kkbubu/STM32CodeDemo/PROGRESS.md

# 任务进度

目标：STM32F103C8T6 HAL，7 路电磁阀控制垂直管道蠕虫机器人，预留 11 路差动控制。

- 用户已确认：二位三通，通电接负压，断电通大气；引脚由本工程规划。
- 用户已确认：两端一路外撑、一路内抓，互斥；中间负压锚定，泄压释放；压力传感器为选装，暂无型号。
- 默认设计：高电平 MOS、7 路、上电锁定；未经接线/气路确认不能启动。
- 新工程单独位于 worm_hal_stm32，不修改已有 ESP32 或气泵工程。
- 已发现 Keil ARMCC5：E:/Keil5/UV4/UV4.exe；宿主测试编译器：E:/Program Files/MATLAB/R2021a/sys/tcc/win64/tcc.exe。
- 官方 HAL/CMSIS 已获取并固定版本，厂商哈希在 docs/vendor-manifest.json。
- 已实现：7/11 路映射、前后爬行、串口 GRIP 外撑/内抓、互斥及支撑交接、通信心跳、故障保持、限时台架点动、可选数字反馈接口。
- tools/test.ps1 的 6 组状态机配置和 4 组 GPIO 配置已通过；包括时间回绕、位图枚举、理想等行程几何约束、抓取切换。
- 最终软件验证于 2026-09-22 完成：7/11 路锁定配置与解锁检查配置均在 ARMCC5 零错误零警告构建，10 组主机测试通过。
- 默认 7 路固件 Flash 9036 字节、RAM 1328 字节；11 路 Flash 9072 字节、RAM 1328 字节。HEX 校验、复位入口、64 KB Flash 边界与 265 个厂商文件哈希验证通过。
- 接线/气路/步态 SVG 与 PNG 已生成并目视核查；README 包含串口指令、解锁、接线、台架调试及反馈扩展说明。
- 已完成代码与软件交付任务；交付包由 tools/package.py 生成，源文件留在本目录。未烧录实机。
- 自动续作 ID：hal；软件交付完成后移除，不再重复运行。

验证边界：只能验证构建和软件逻辑，未连接机器人，不声称实机垂直运动成功。
