kkbubu/STM32CodeDemo/docs/gait.png

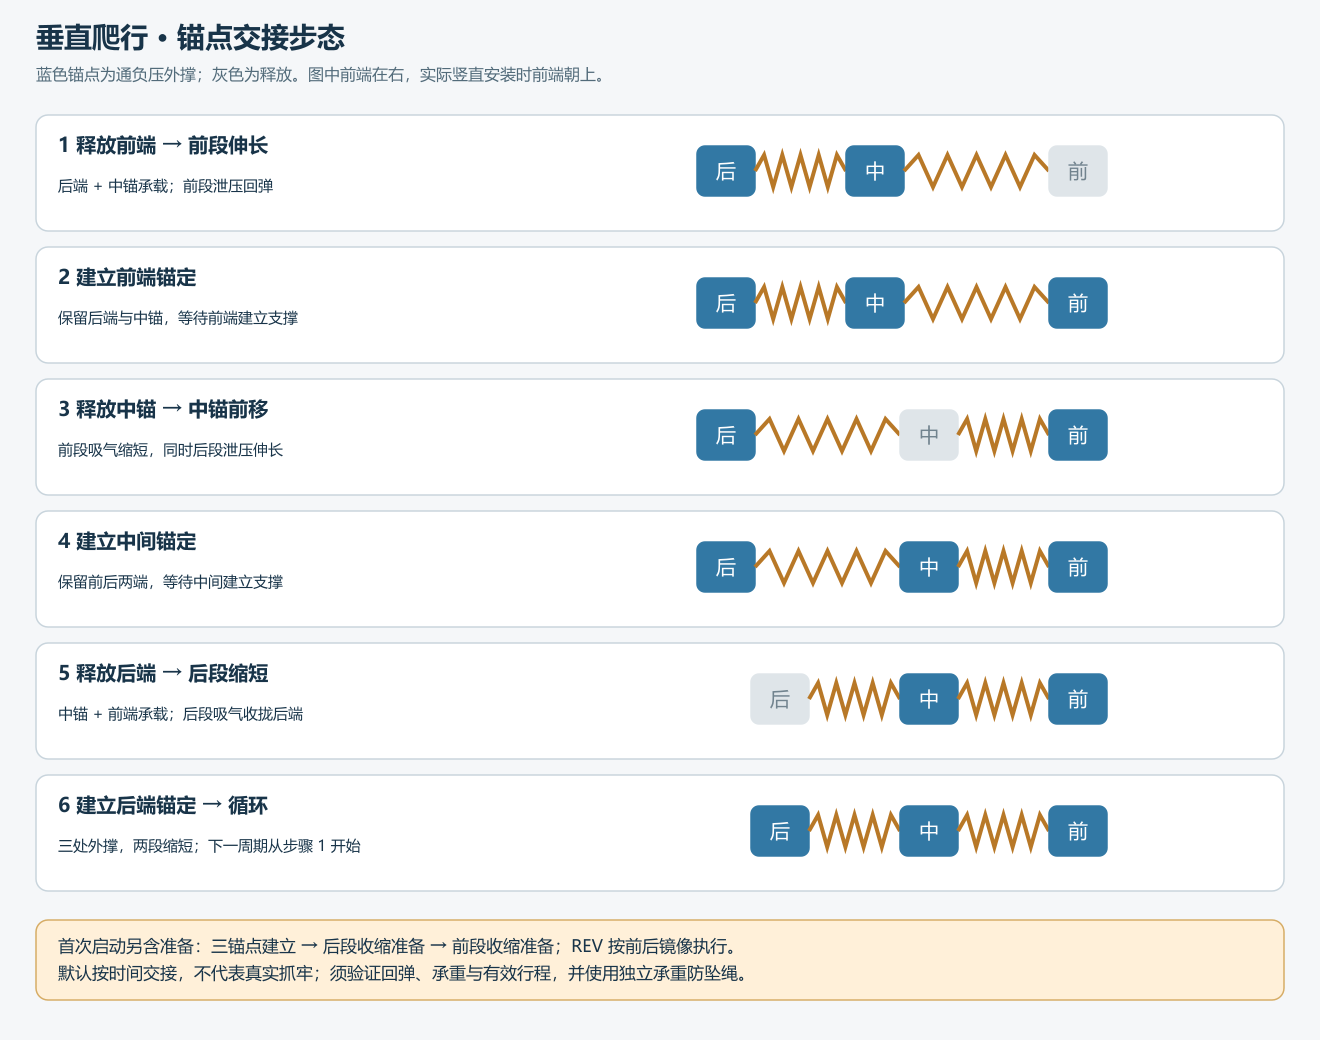
docs/gait.png
