kkbubu/STM32CodeDemo/docs/pneumatics.png

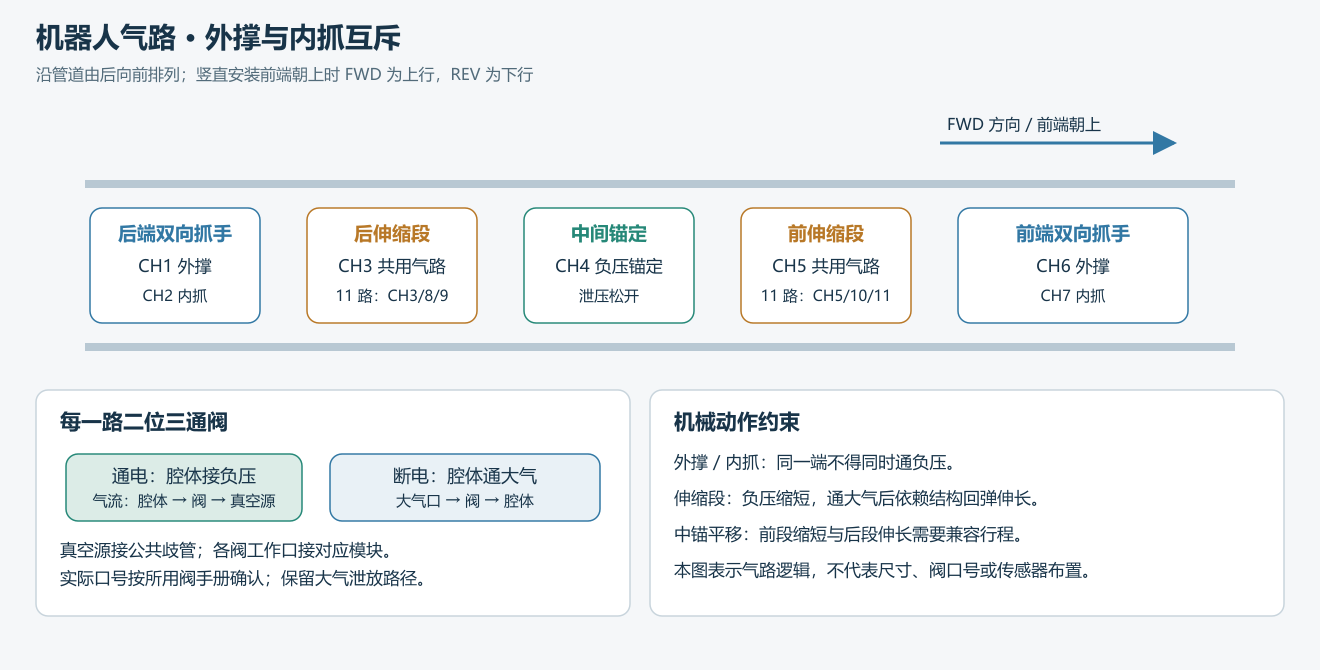
docs/pneumatics.png
