kkbubu/STM32CodeDemo/docs/wiring.png

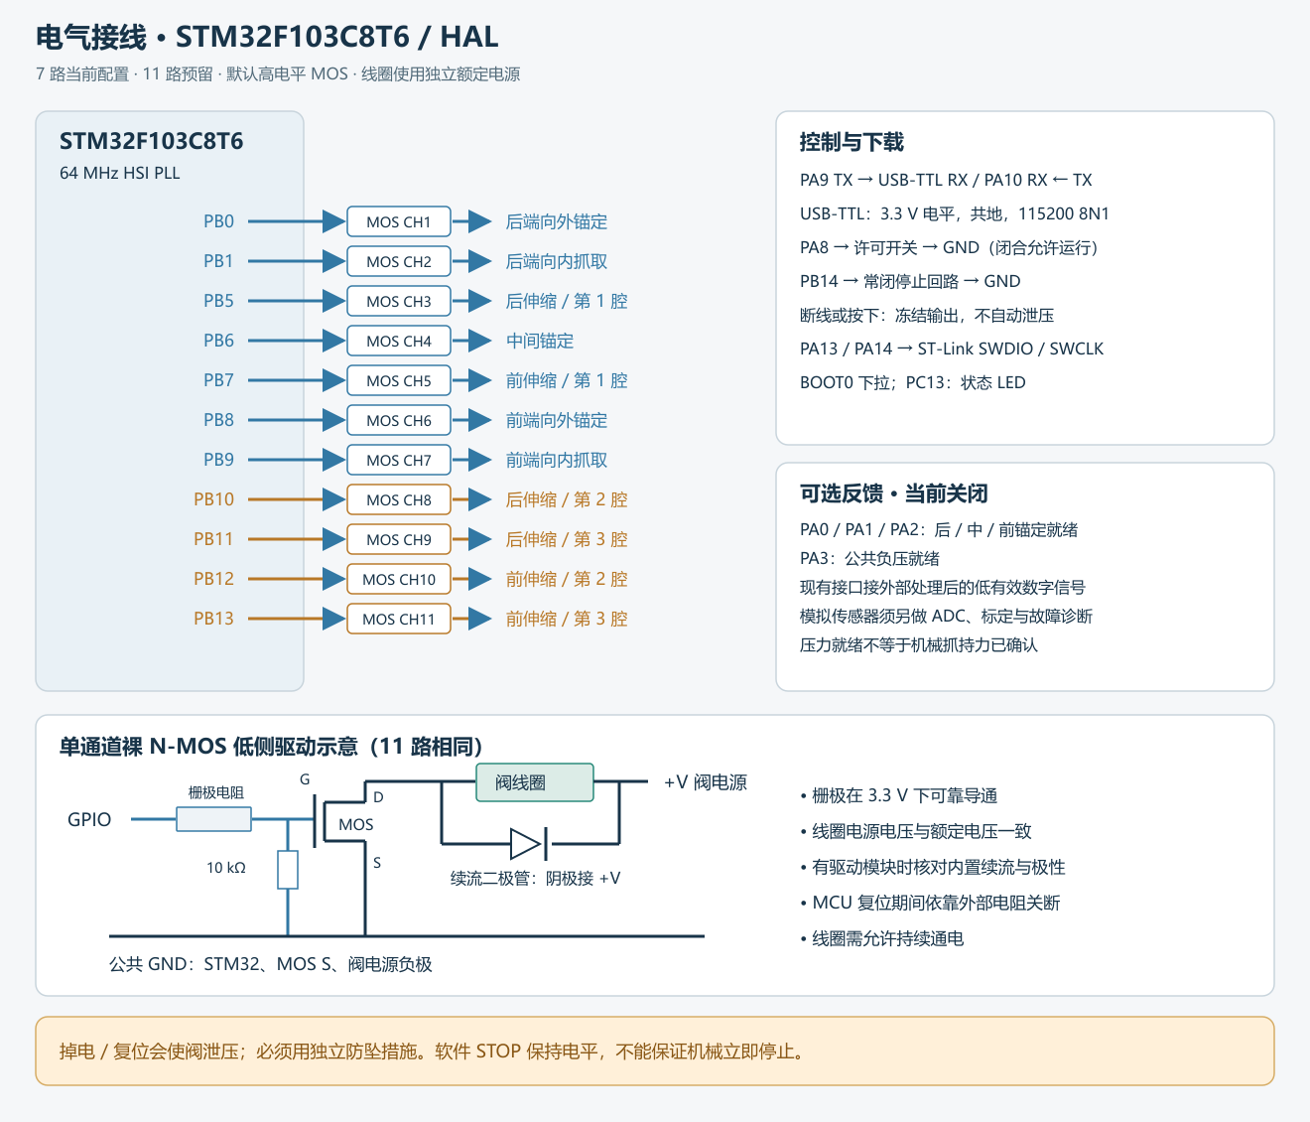
docs/wiring.png
