kkbubu/STM32CodeDemo/STM32CodeDemo.ioc

Mcu.UserName=STM32F103C8Tx
PA13.Signal=SYS_JTMS-SWDIO
PA14.Signal=SYS_JTCK-SWCLK
PA6.GPIO_Label=LED
PA6.Signal=GPIO_Output
