kkbubu/STM32CodeDemo/(commit log)

2026-05-21 Initial commit: STM32F103 project with HAL drivers and CMake build system
2026-09-23 新增 STM32 气动蠕虫机器人控制工程
2026-09-23 忽略 Keil 本地用户配置
